xiaokepanyvzhobo-web/tinyriscv_dk/tinyriscv/fpga/images/add_mcs_device.png

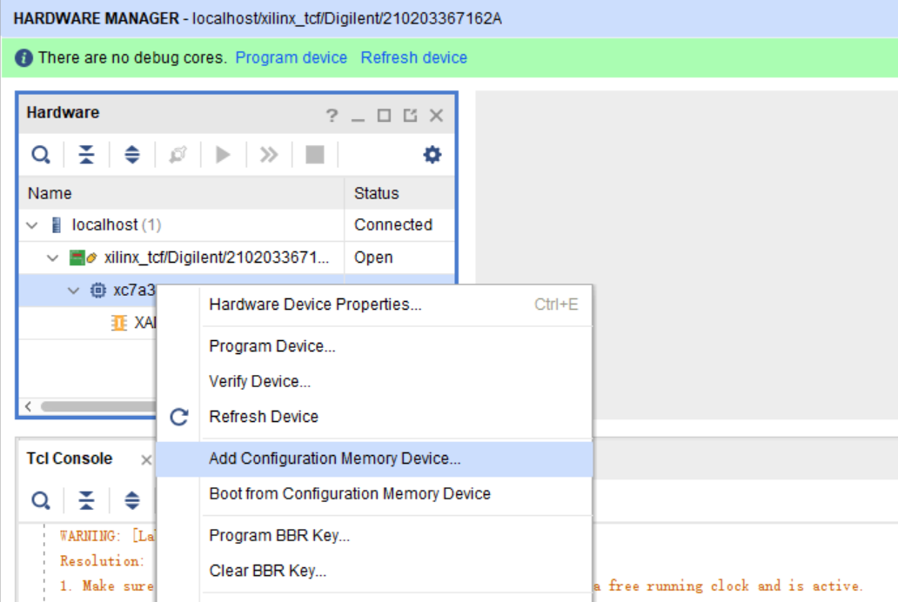
tinyriscv/fpga/images/add_mcs_device.png
