xiaokepanyvzhobo-web/tinyriscv_dk/tinyriscv/fpga/images/add_sim.png

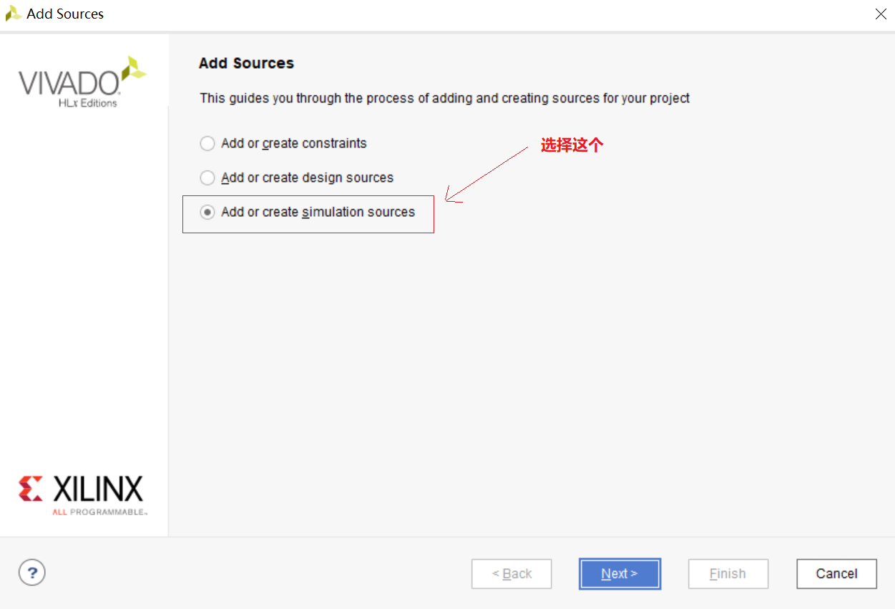
tinyriscv/fpga/images/add_sim.png
