xiaokepanyvzhobo-web/tinyriscv_dk/tinyriscv/fpga/images/add_src_1.png

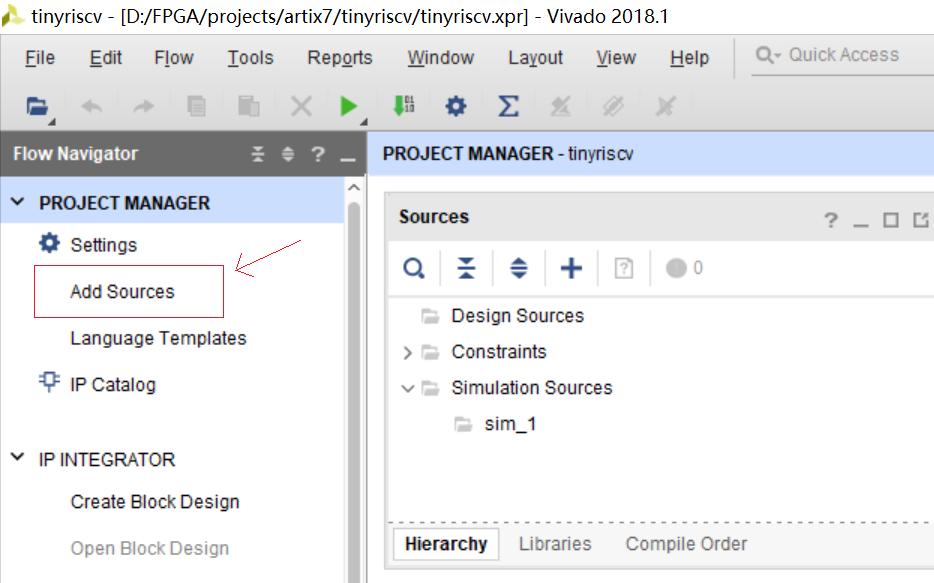
tinyriscv/fpga/images/add_src_1.png
