xiaokepanyvzhobo-web/tinyriscv_dk/tinyriscv/fpga/images/add_src_2.png

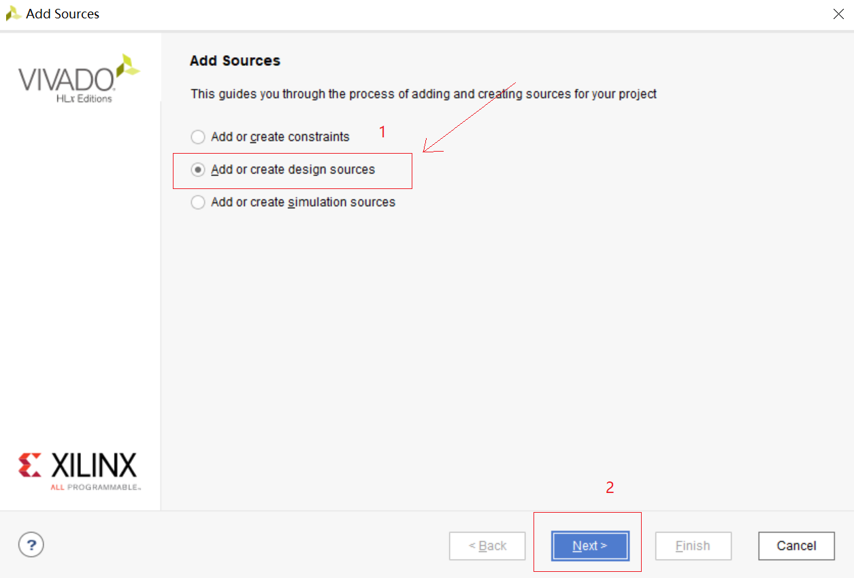
tinyriscv/fpga/images/add_src_2.png
