xiaokepanyvzhobo-web/tinyriscv_dk/tinyriscv/fpga/images/add_src_3.png

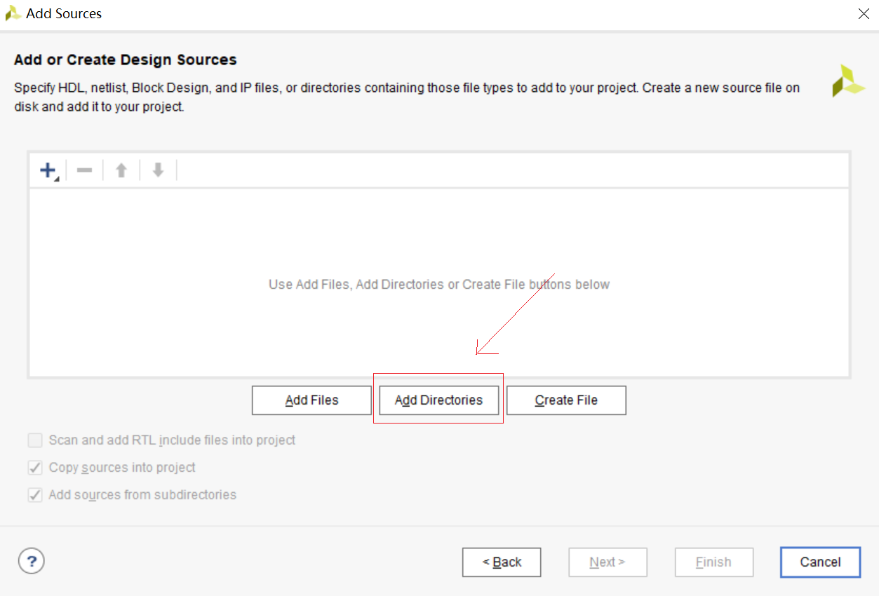
tinyriscv/fpga/images/add_src_3.png
