xiaokepanyvzhobo-web/tinyriscv_dk/tinyriscv/fpga/images/add_src_4.png

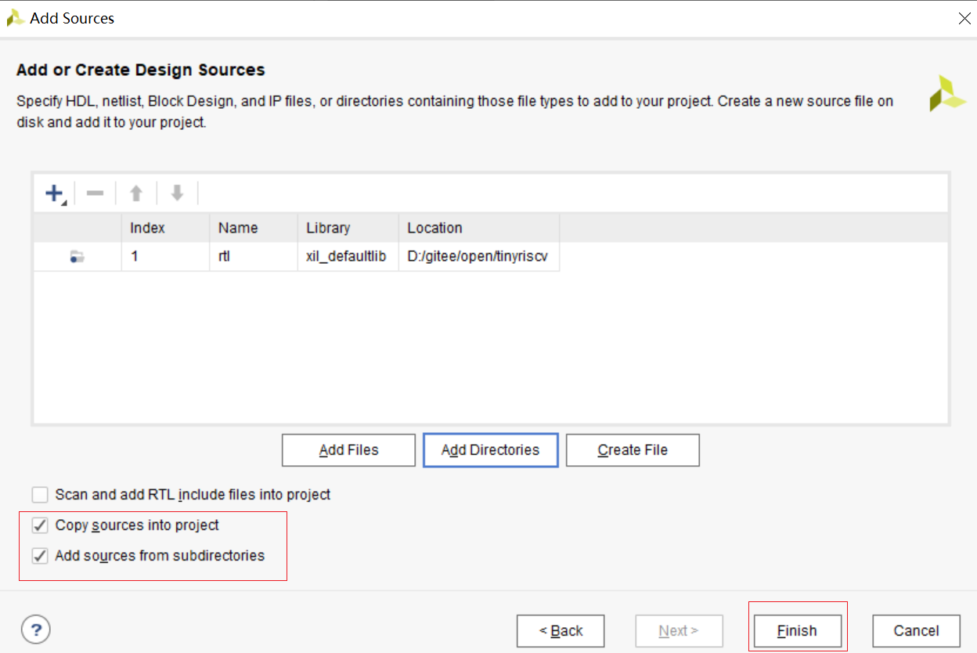
tinyriscv/fpga/images/add_src_4.png
