xiaokepanyvzhobo-web/tinyriscv_dk/tinyriscv/fpga/images/add_src_5.png

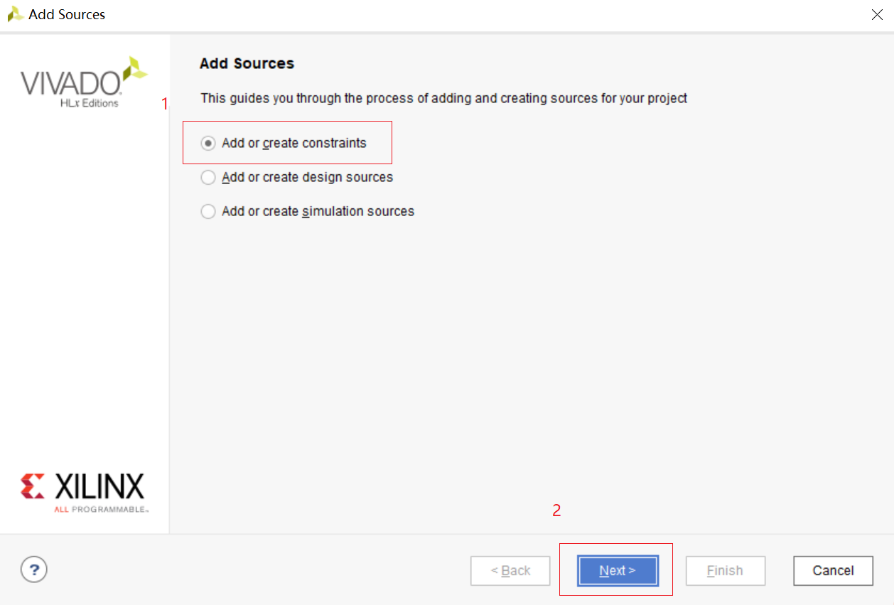
tinyriscv/fpga/images/add_src_5.png
