xiaokepanyvzhobo-web/tinyriscv_dk/tinyriscv/fpga/images/add_src_6.png

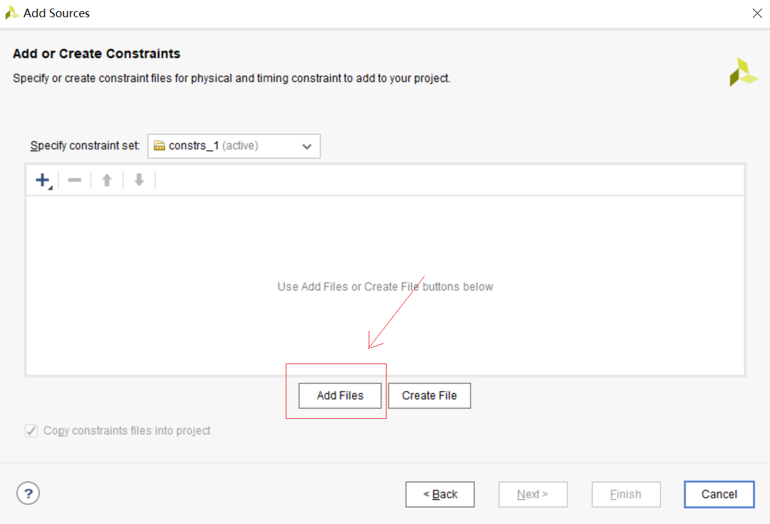
tinyriscv/fpga/images/add_src_6.png
