xiaokepanyvzhobo-web/tinyriscv_dk/tinyriscv/fpga/images/add_src_7.png

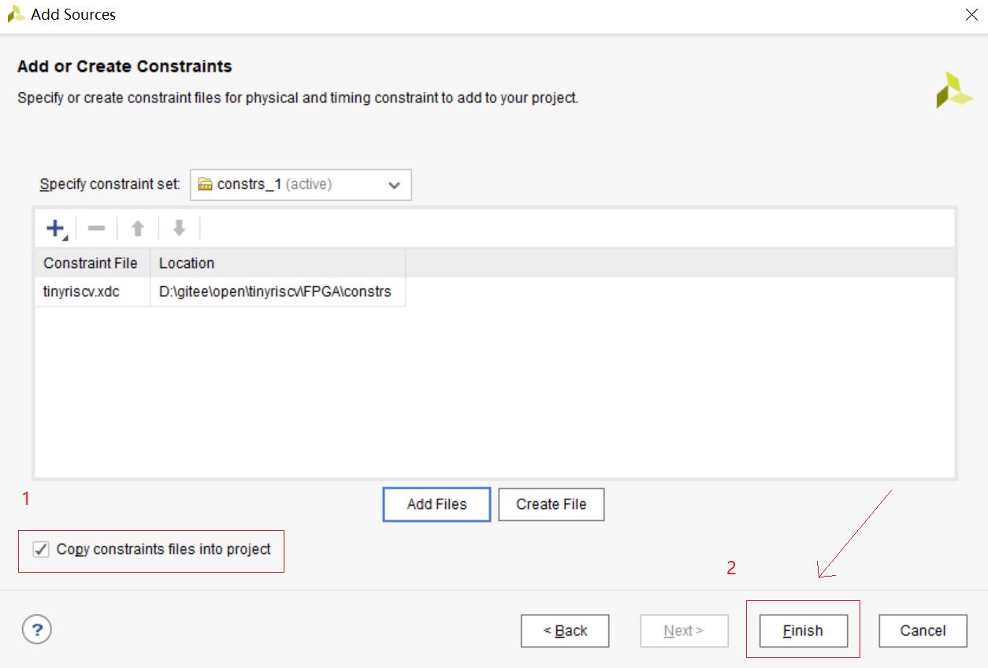
tinyriscv/fpga/images/add_src_7.png
