xiaokepanyvzhobo-web/tinyriscv_dk/tinyriscv/fpga/images/add_src_8.png

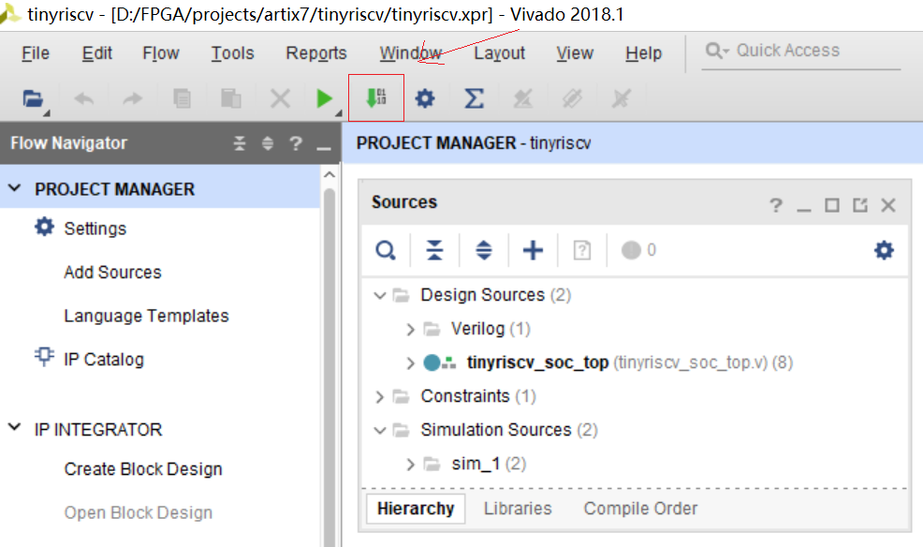
tinyriscv/fpga/images/add_src_8.png
