xiaokepanyvzhobo-web/tinyriscv_dk/tinyriscv/fpga/images/config_mcs.png

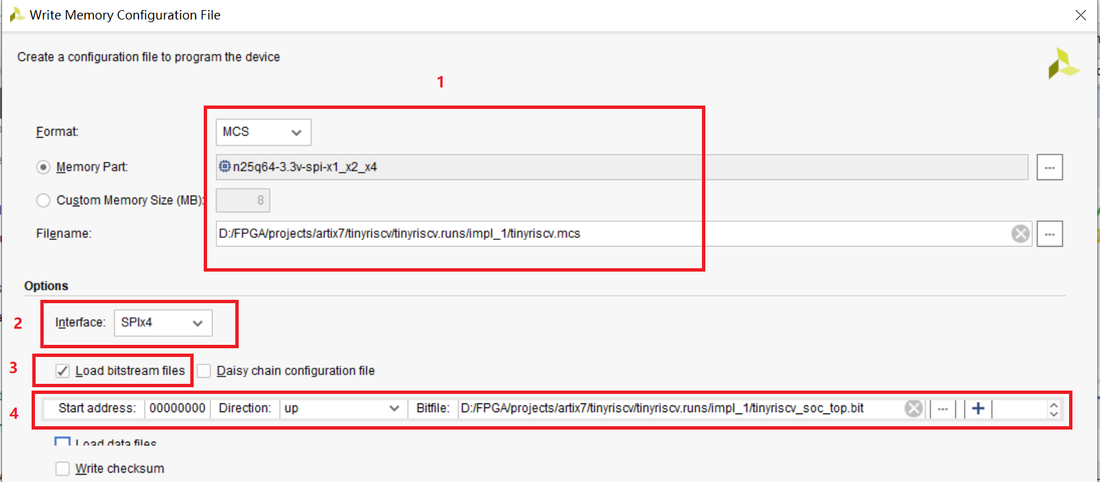
tinyriscv/fpga/images/config_mcs.png
