xiaokepanyvzhobo-web/tinyriscv_dk/tinyriscv/fpga/images/create_prj_1.png

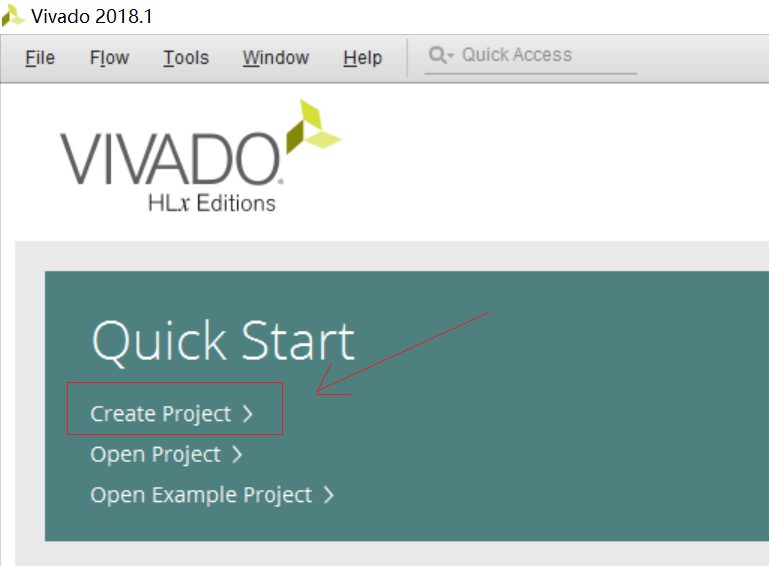
tinyriscv/fpga/images/create_prj_1.png
