xiaokepanyvzhobo-web/tinyriscv_dk/tinyriscv/fpga/images/create_prj_2.png

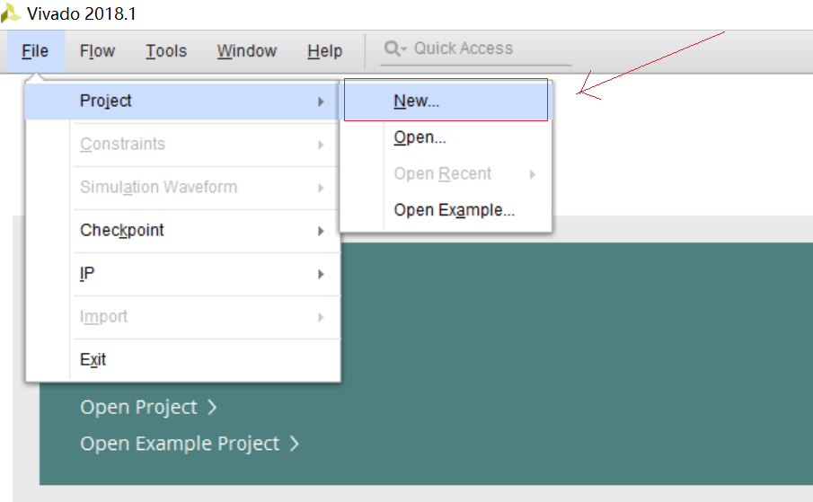
tinyriscv/fpga/images/create_prj_2.png
