xiaokepanyvzhobo-web/tinyriscv_dk/tinyriscv/fpga/images/create_prj_3.png

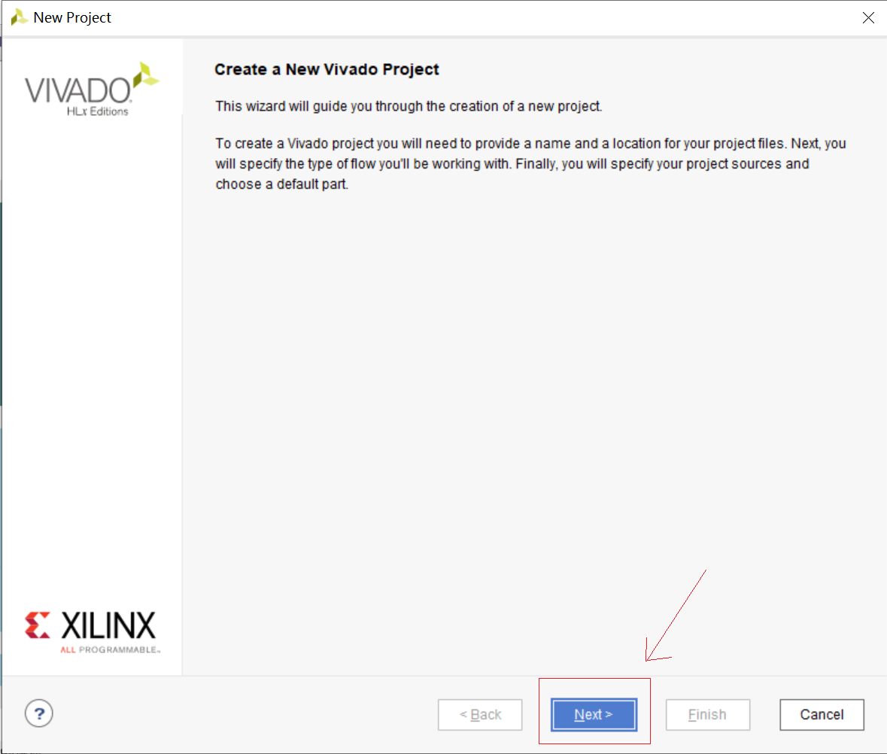
tinyriscv/fpga/images/create_prj_3.png
