xiaokepanyvzhobo-web/tinyriscv_dk/tinyriscv/fpga/images/create_prj_4.png

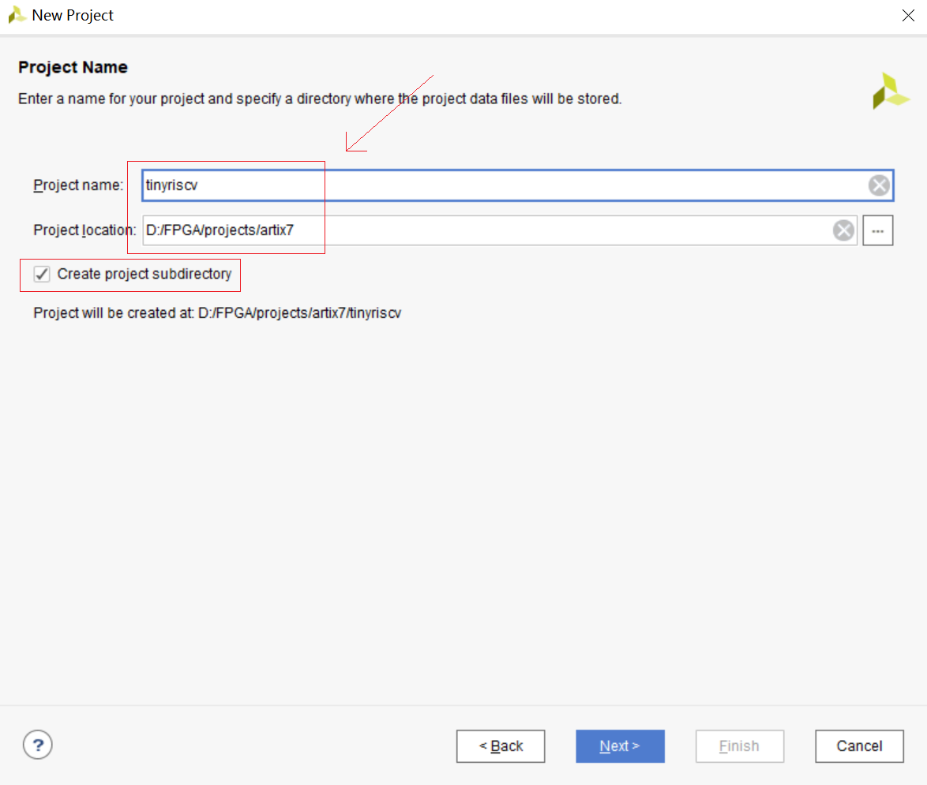
tinyriscv/fpga/images/create_prj_4.png
