xiaokepanyvzhobo-web/tinyriscv_dk/tinyriscv/fpga/images/create_prj_5.png

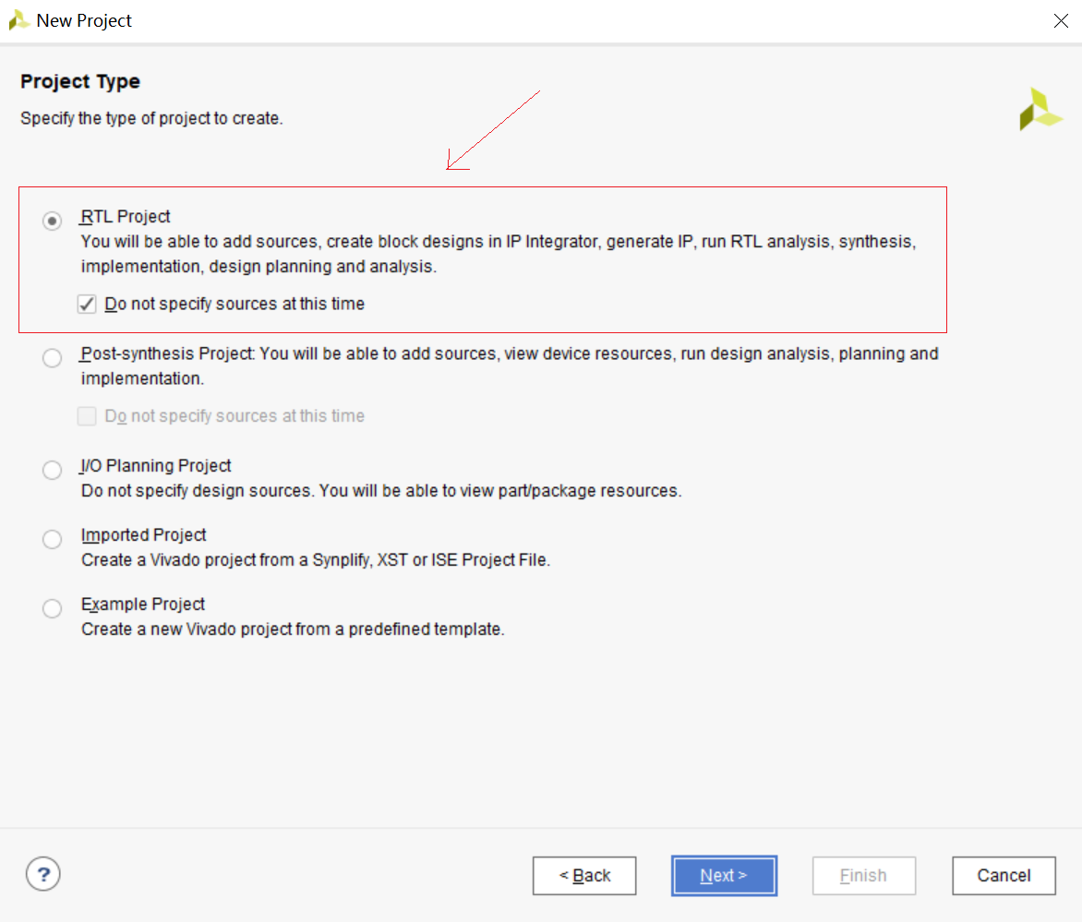
tinyriscv/fpga/images/create_prj_5.png
