xiaokepanyvzhobo-web/tinyriscv_dk/tinyriscv/fpga/images/create_prj_6.png

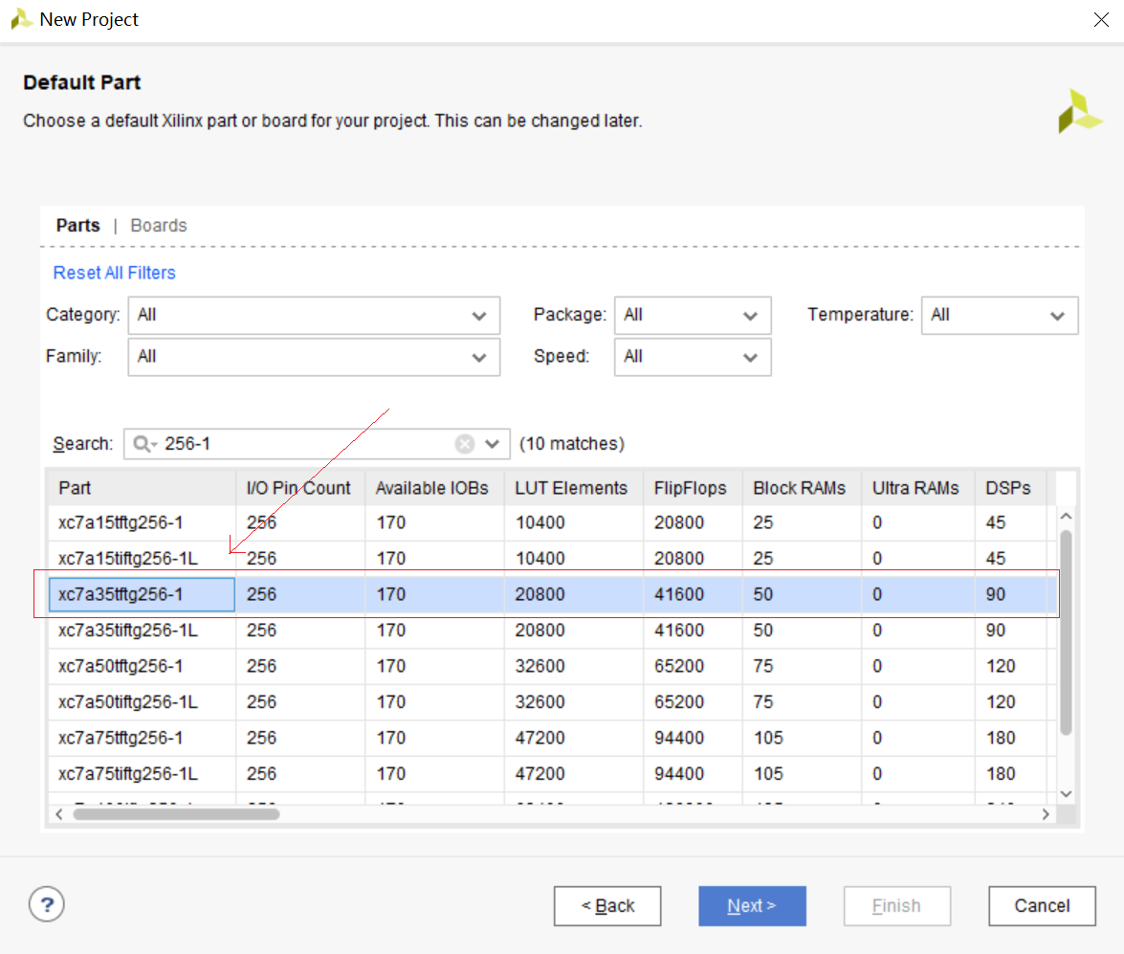
tinyriscv/fpga/images/create_prj_6.png
