xiaokepanyvzhobo-web/tinyriscv_dk/tinyriscv/fpga/images/create_prj_7.png

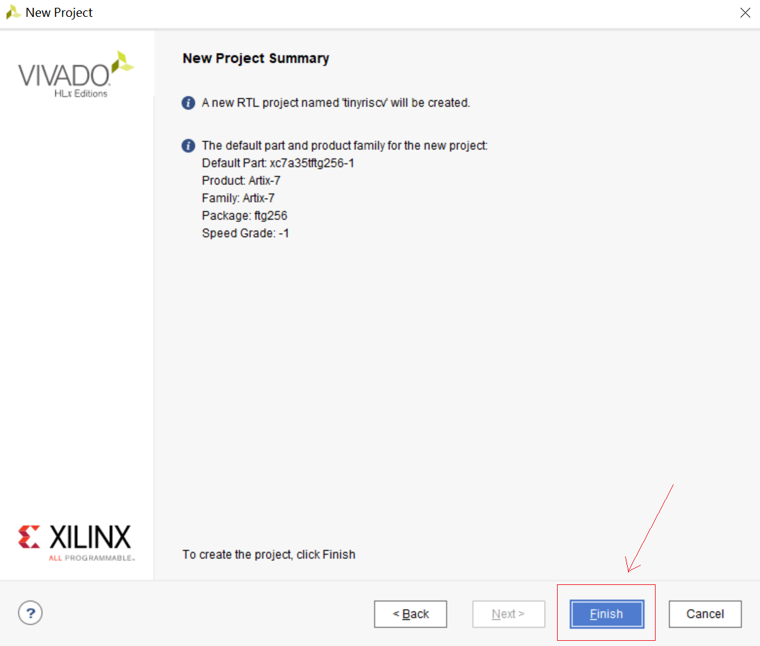
tinyriscv/fpga/images/create_prj_7.png
