xiaokepanyvzhobo-web/tinyriscv_dk/tinyriscv/fpga/images/defines.png

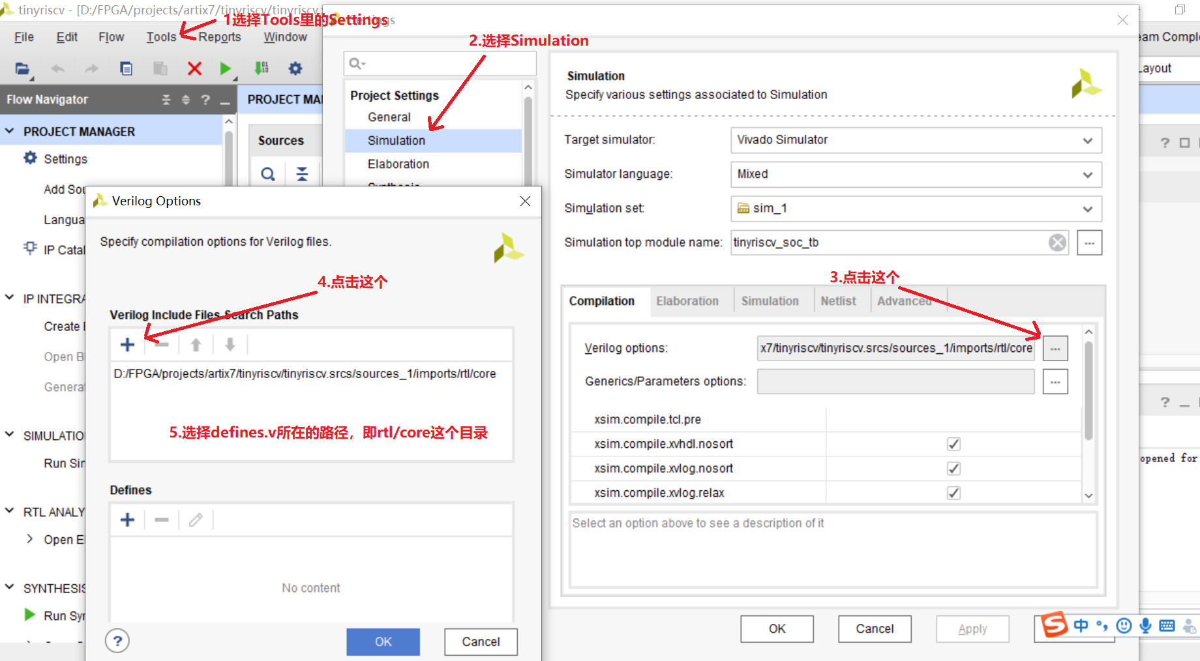
tinyriscv/fpga/images/defines.png
