xiaokepanyvzhobo-web/tinyriscv_dk/tinyriscv/fpga/images/download_1.png

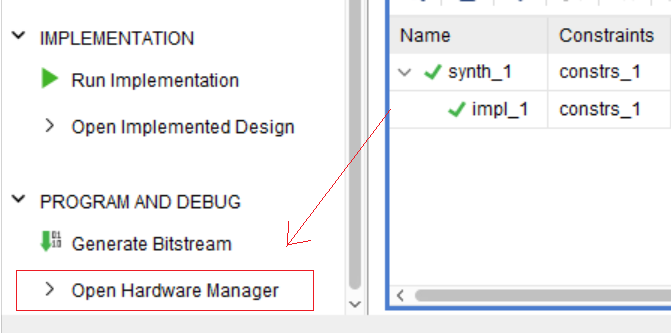
tinyriscv/fpga/images/download_1.png
