xiaokepanyvzhobo-web/tinyriscv_dk/tinyriscv/fpga/images/download_2.png

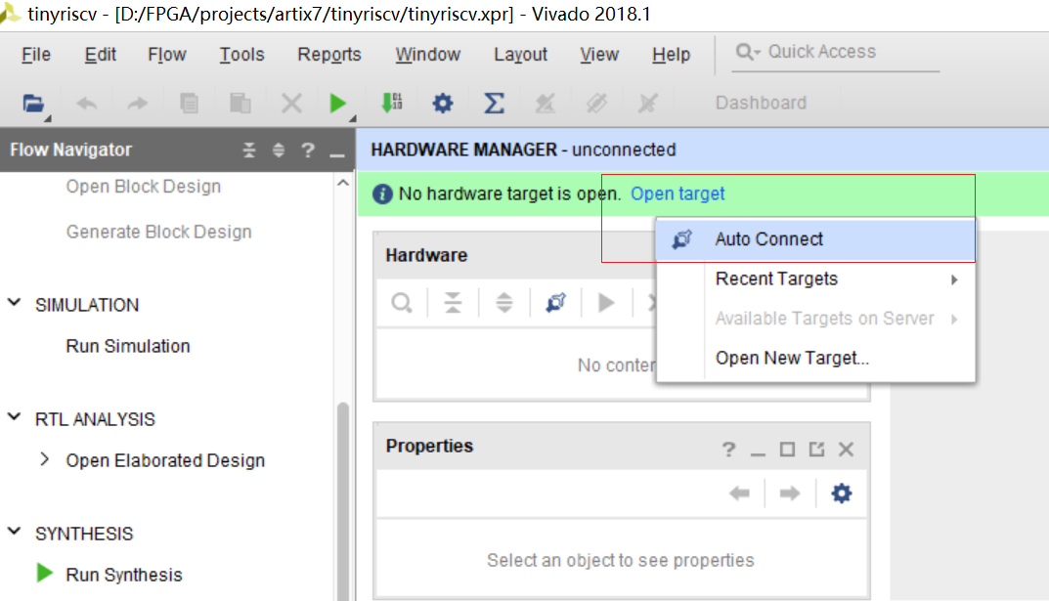
tinyriscv/fpga/images/download_2.png
