xiaokepanyvzhobo-web/tinyriscv_dk/tinyriscv/fpga/images/download_3.png

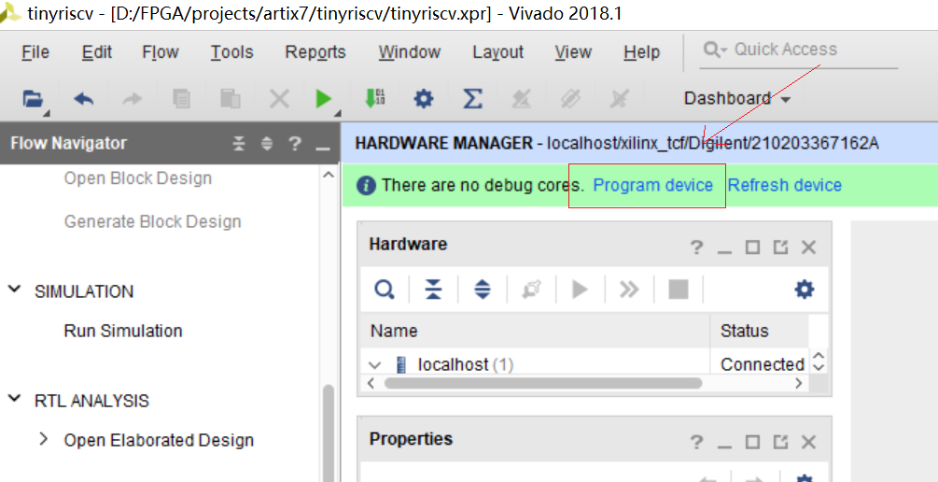
tinyriscv/fpga/images/download_3.png
