xiaokepanyvzhobo-web/tinyriscv_dk/tinyriscv/fpga/images/download_4.png

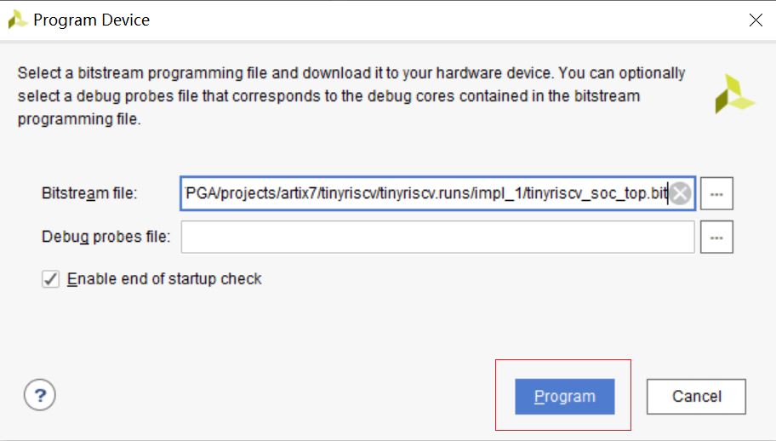
tinyriscv/fpga/images/download_4.png
