xiaokepanyvzhobo-web/tinyriscv_dk/tinyriscv/fpga/images/mcs_ok.png

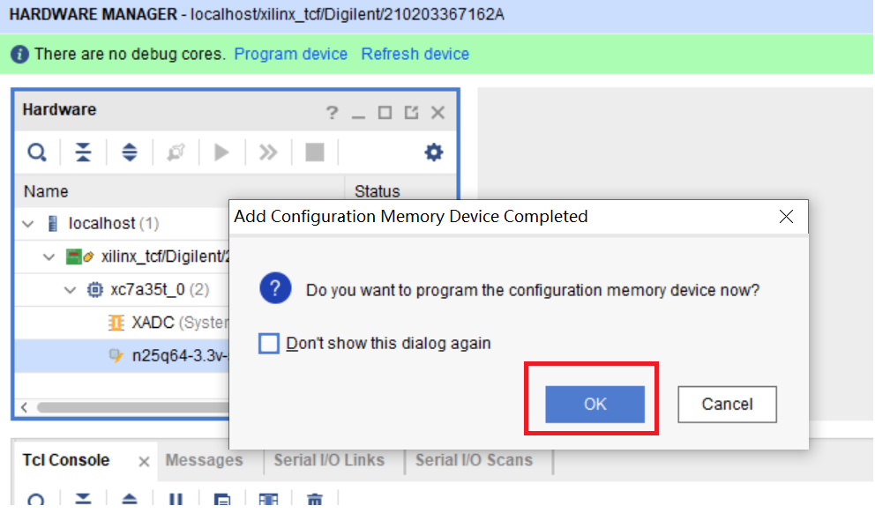
tinyriscv/fpga/images/mcs_ok.png
