xiaokepanyvzhobo-web/tinyriscv_dk/tinyriscv/fpga/images/mcs_prog.png

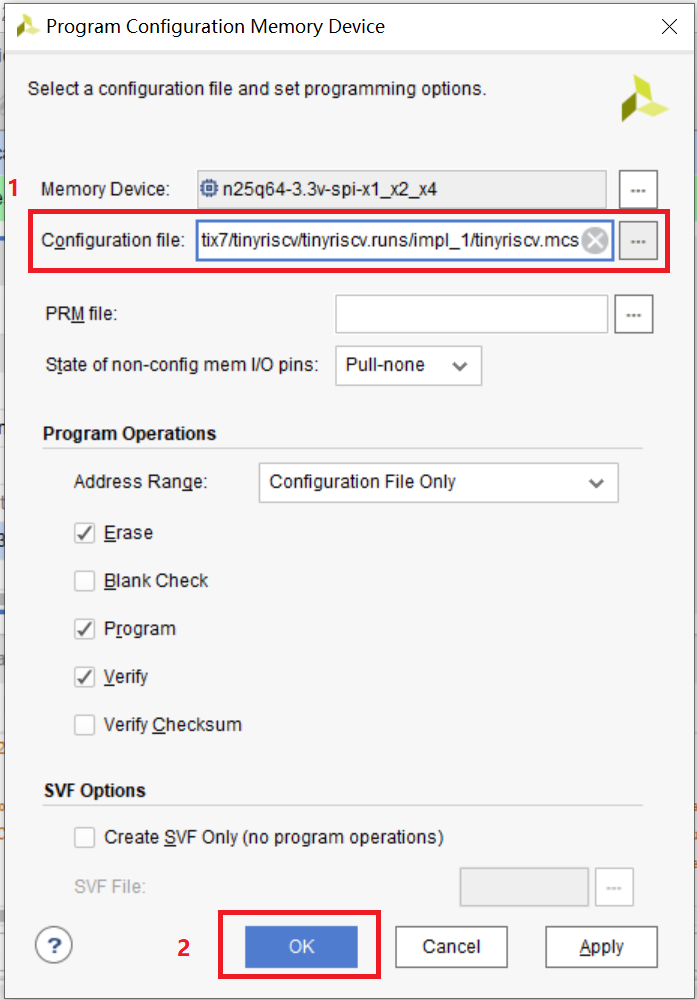
tinyriscv/fpga/images/mcs_prog.png
