xiaokepanyvzhobo-web/tinyriscv_dk/tinyriscv/fpga/images/openocd.png

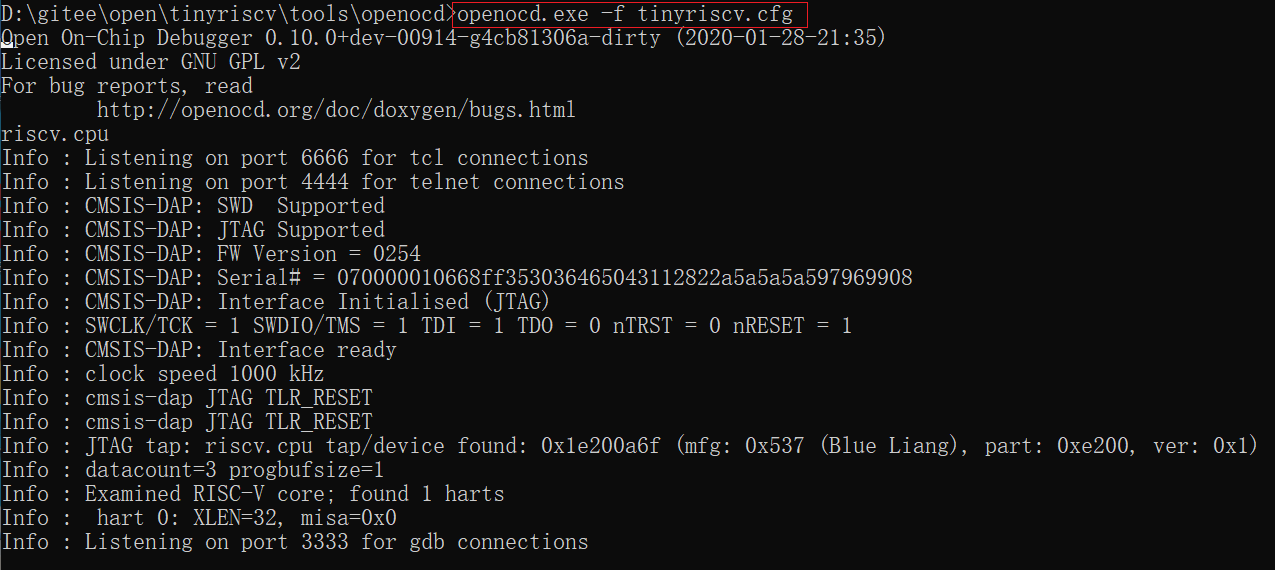
tinyriscv/fpga/images/openocd.png
