xiaokepanyvzhobo-web/tinyriscv_dk/tinyriscv/fpga/images/openocd_cli.png

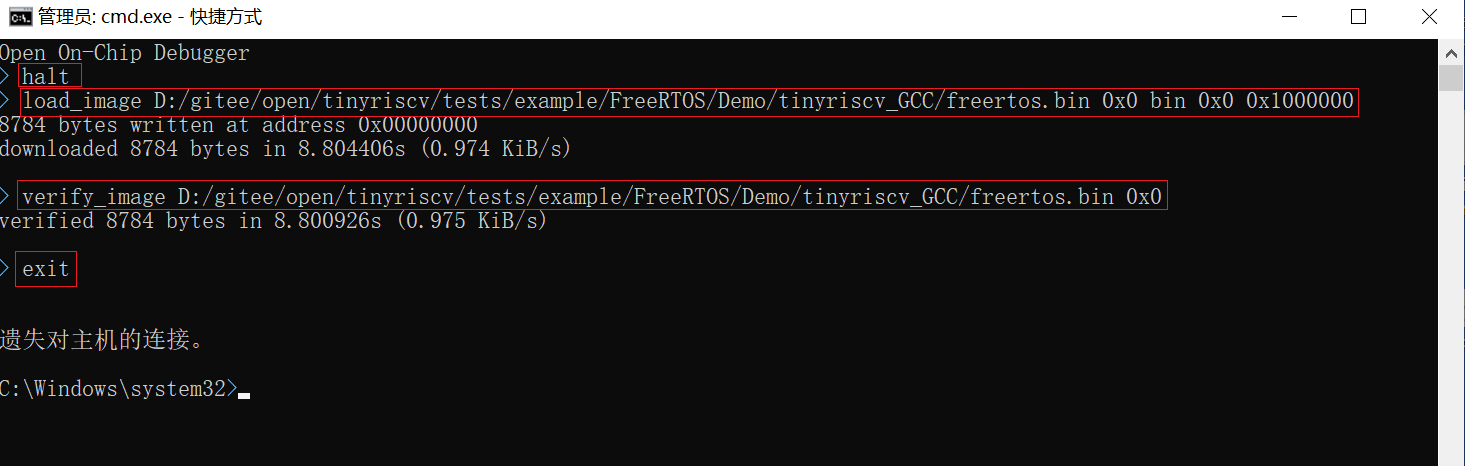
tinyriscv/fpga/images/openocd_cli.png
