xiaokepanyvzhobo-web/tinyriscv_dk/tinyriscv/fpga/images/select_spi.png

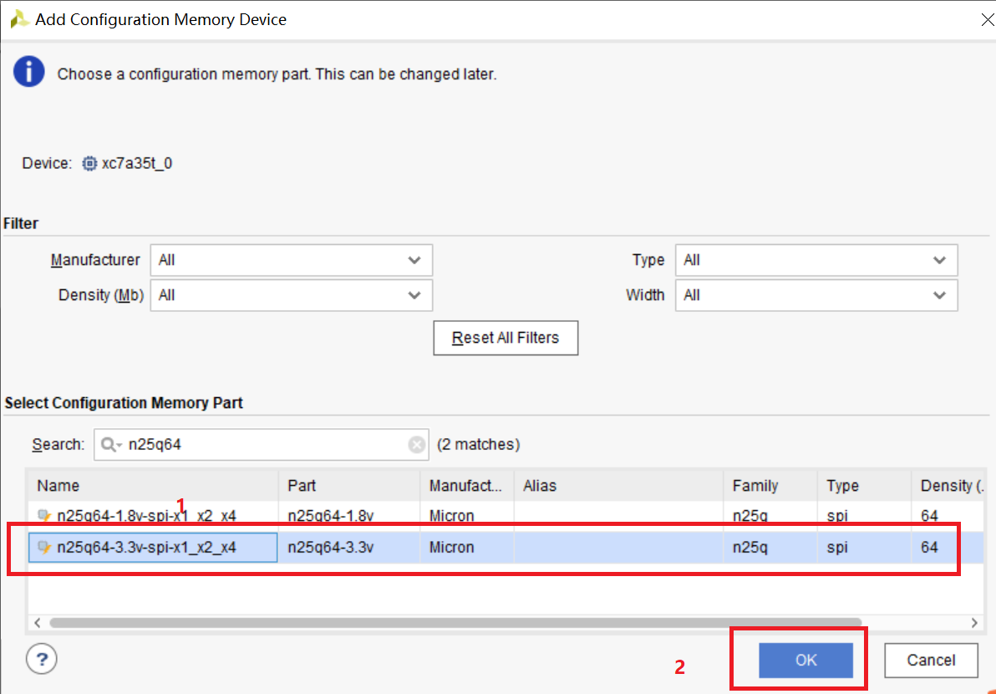
tinyriscv/fpga/images/select_spi.png
