xiaokepanyvzhobo-web/tinyriscv_dk/tinyriscv/pic/test_output.png

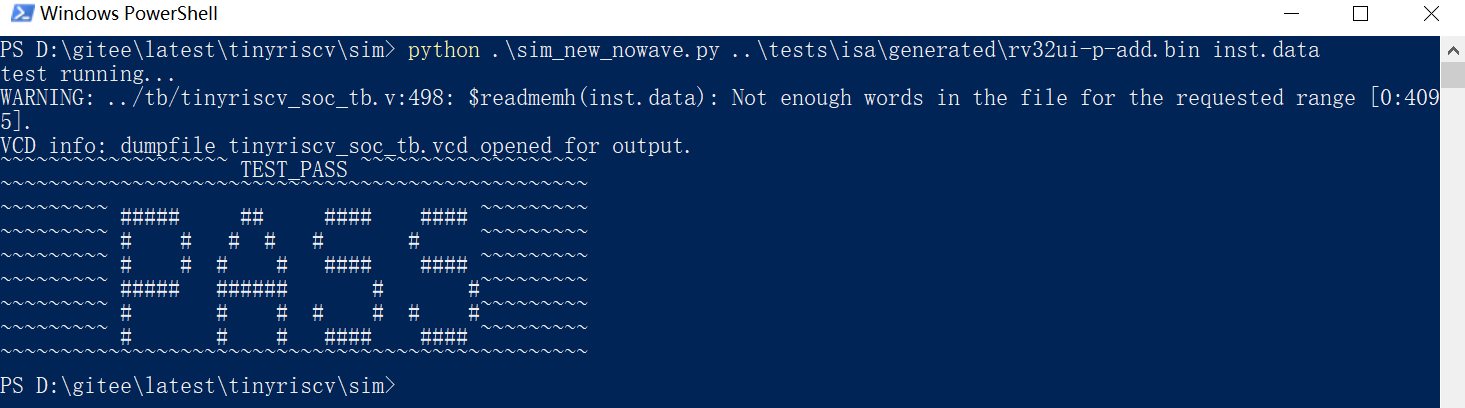
tinyriscv/pic/test_output.png
