xiaokepanyvzhobo-web/tinyriscv_dk/tinyriscv/tests/riscv-compliance/spec/testpool.jpg

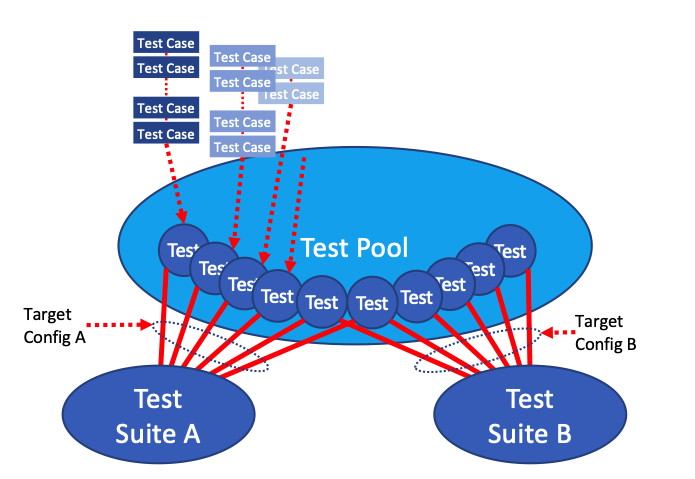
tinyriscv/tests/riscv-compliance/spec/testpool.jpg
