xiaokepanyvzhobo-web/tinyriscv_dk/(commit log)

2026-04-28 first to commit Verilog codes
    [tinyriscv.cfg]
2026-05-08 mkdir liudk_test and ready to test bridge seperately, AI helps to modify and correct the verilog codes
    [bridge_master.v, bridge_slave.v, bridge_top.v, defines.v, ram.v, rom.v]
